AL2TECH/Project_LEOLED/PCB/Rev_1/Outputs/PDF/LEOLED_rev1_SCHEMATIC.pdf

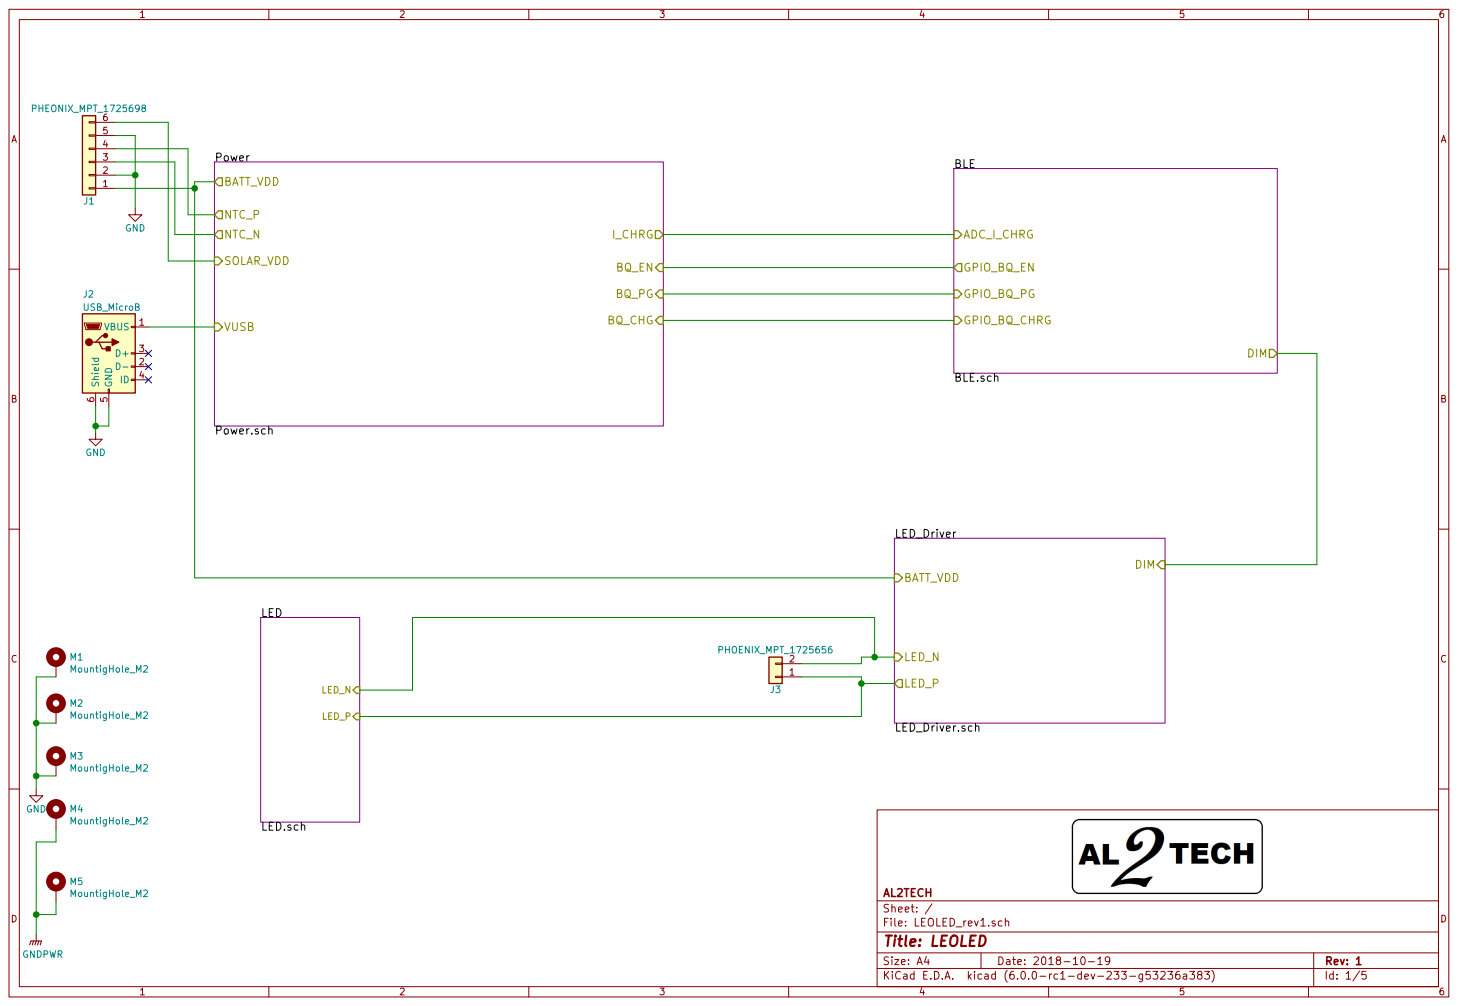
[picture p1: page 1]

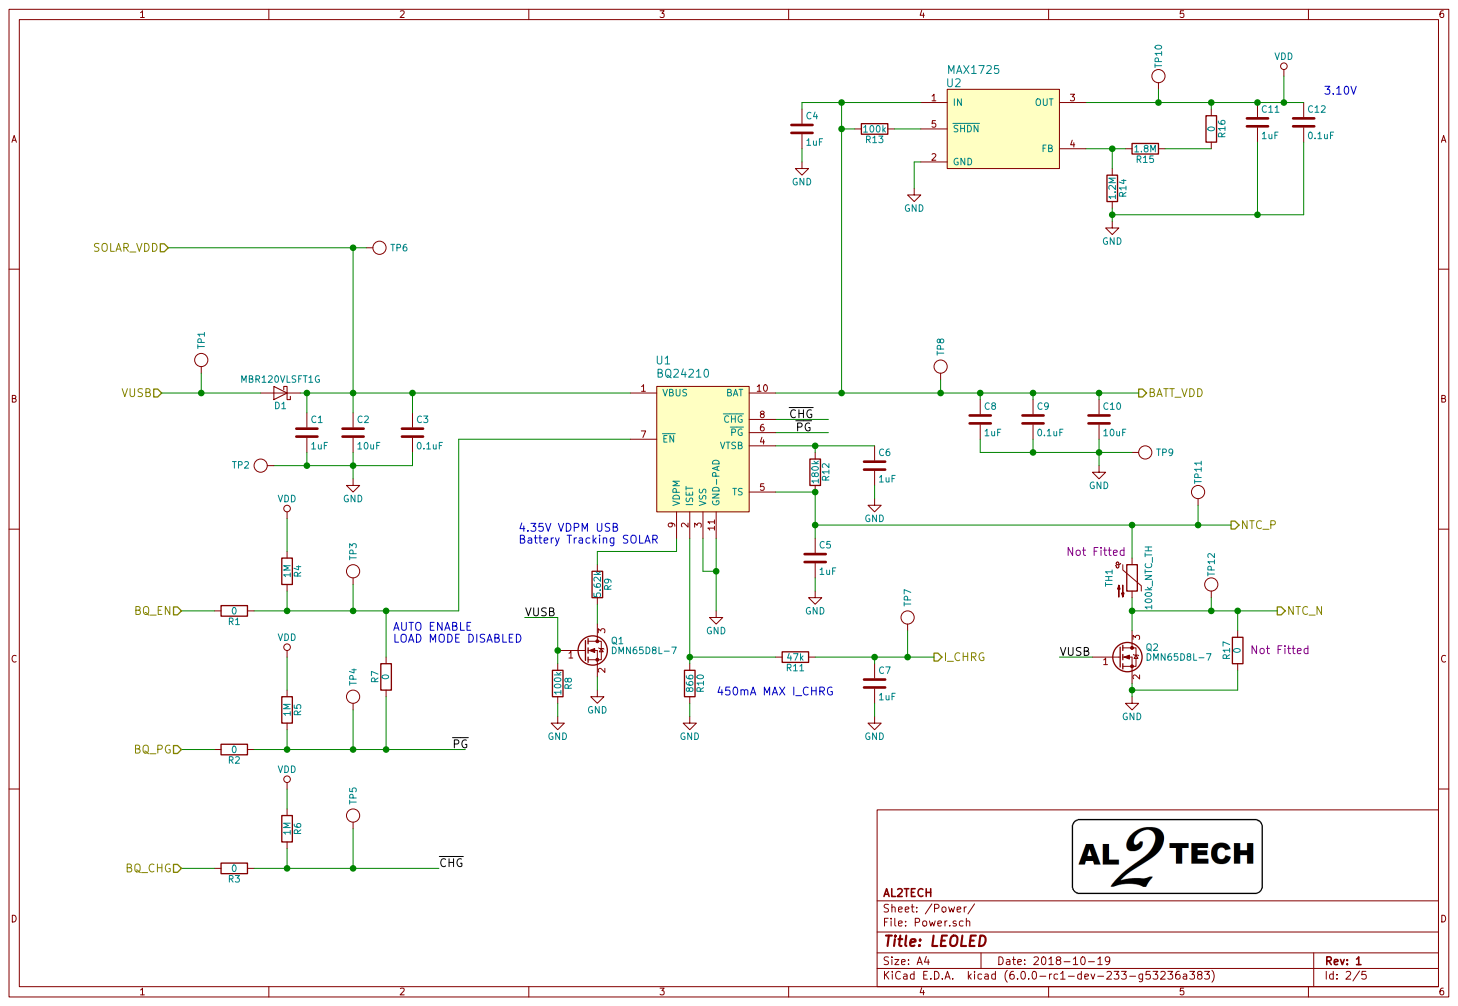
[picture p2: page 2]

3 VTSB 4 TS 5 PG 6 EN 7 CHG 8 VDPM

2 3 Q2DMN65D8L-7 GND VUSB R170Not Fitted TH1 100k_NTC_THNot Fitted 180k R12 C6

File: Power.sch Sheet: /Power/ AL2TECH

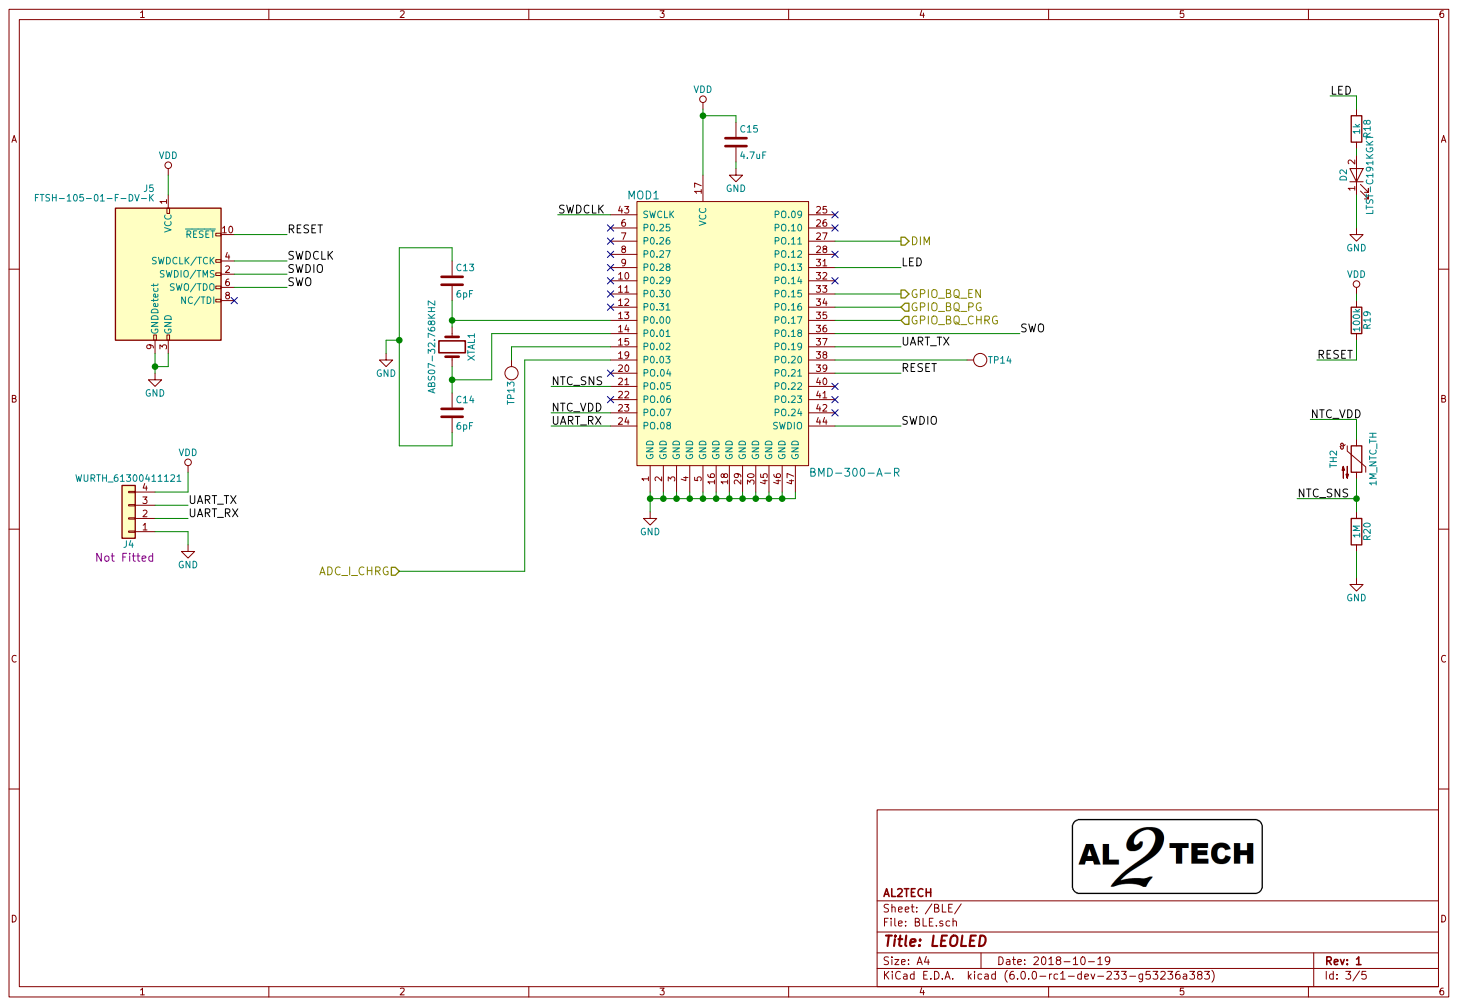
[picture p3: page 3]

5 P0.25 6 P0.26 7 P0.27 8 P0.28 9 P0.29 10 PO.04 20 GND 30 PO.22 40 P0.30 11 PO.05 21 PO.13 31 PO.23 41 P0.31 12 PO.06 22 PO.14 32 PO.24 42 P0.00 13 PO.07 23 PO.15 33 SWCLK 43 P0.01 14 PO.08 24 PO.16 34 SWDIO 44 P0.02 15 PO.09 25 PO.17 35 GND 45 GND 16 PO.10 26 PO.18 36 GND 46 VCC 17 PO.11 27 PO.19 37 GND 47 GND 18 PO.12 28 PO.20 38 P0.03 19 GND 29 PO.21 39 MOD1 BMD-300-A-R

3 SWDCLK/TCK 4 SWO/TDO 6 NC/TDI 8 GNDDetect 9 RESET 10

File: BLE.sch Sheet: /BLE/ AL2TECH GND

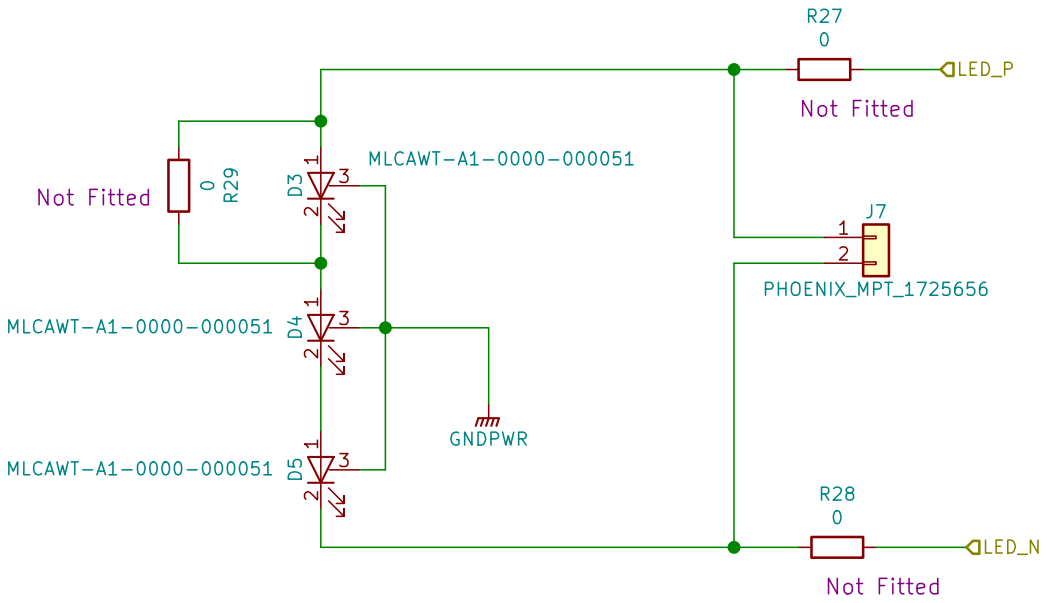
[picture p4: page 4]

File: LED.sch Sheet: /LED/ AL2TECH

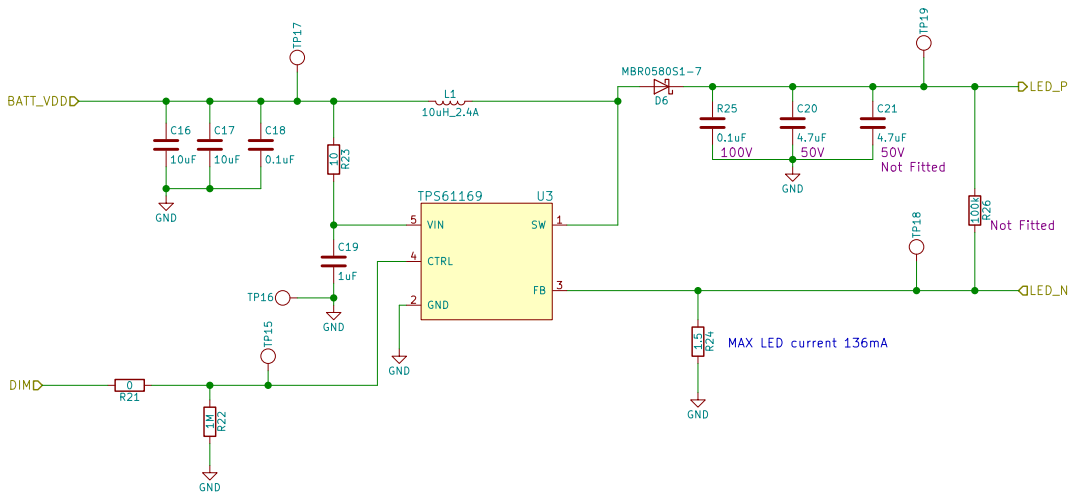
[picture p5: page 5]
