AL2TECH/Project_LEOLED/PCB/Rev_1/Outputs/Assembly/LEOLED_rev1-Assembly_BOTTOM.pdf

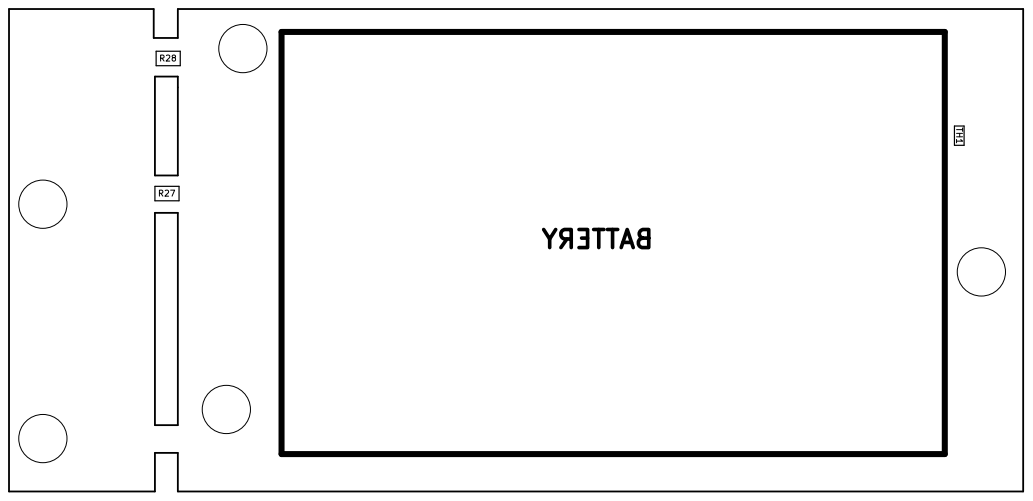
[picture p6: page 1]
