AL2TECH/Project_LEOLED/PCB/Rev_1/Outputs/Assembly/LEOLED_rev1-Assembly_TOP.pdf

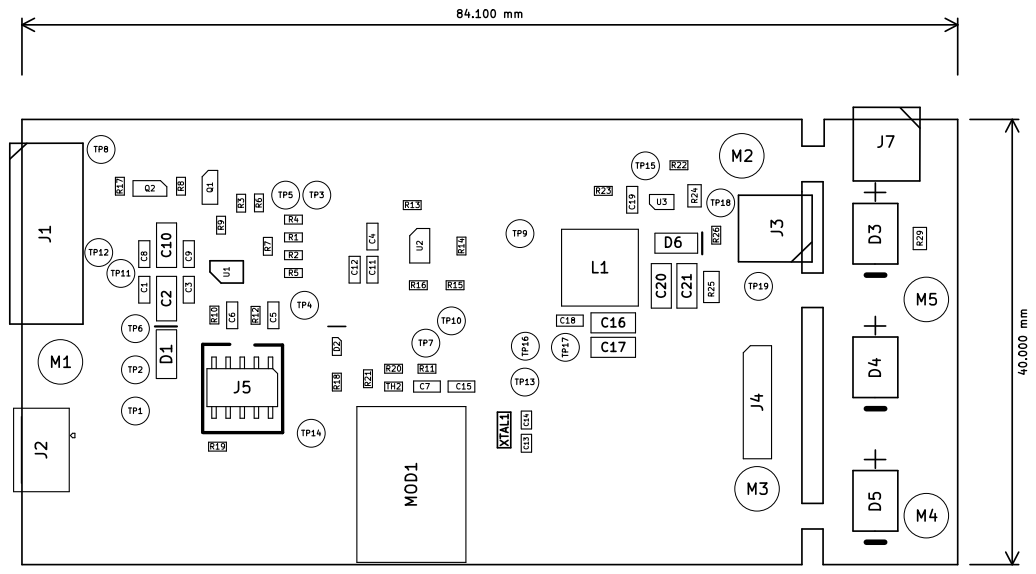
[picture p7: page 1]
