AL2TECH/Project_LEOLED/(commit log)

2018-06-27 layout edit
    [LED.sch, LEOLED_rev1.kicad_pcb]
2018-06-28 layout editing
    [LEOLED_rev1.kicad_pcb, Power.sch]
2018-07-01 added assembly folder
    [LEOLED_rev1.kicad_pcb]
2018-07-17 adding assembly folder
    [position.csv]
2018-08-09 generating output files
    [LEOLED_rev1-BOTTOM.gbr, LEOLED_rev1-EdgeCuts.gbr, LEOLED_rev1-MaskBottom.gbr, LEOLED_rev1-MaskTop.gbr, LEOLED_rev1-PasteBottom.gbr, LEOLED_rev1-PasteTop.gbr, LEOLED_rev1-SilkBottom.gbr, LEOLED_rev1-SilkTop.gbr]
2018-09-04 UART header not fitted
    [BLE.sch, LEOLED_rev1.kicad_pcb, LEOLED_rev1.sch, LEOLED_rev1_BOM.csv]
2018-10-19 Adding gerber job file and PDFs
    [BLE.sch, LED.sch, LED_Driver.sch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]
2019-04-29 cleaning up
    [LED.sch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]
